jpclark6/LEData/images/trans_fall.png

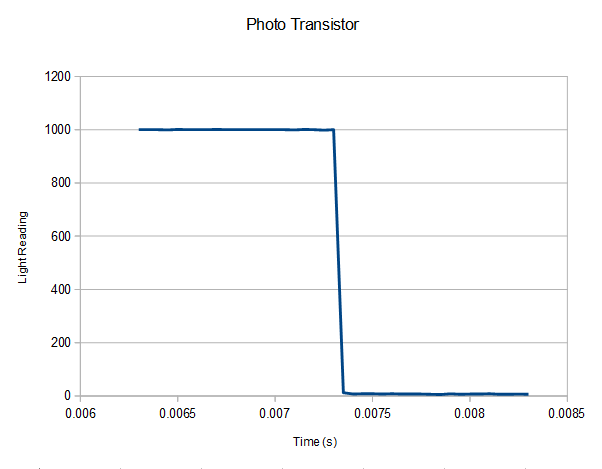
[picture p6: images/trans_fall.png]
